keeganmjgreen/rc_car/docs/index.md

# RC Car Mark II

## Power Electronics Design — Custom Unidirectional [Motor Driver](https://en.wikipedia.org/wiki/Motor_controller)

[~~Motor Soft Starter~~](https://en.wikipedia.org/wiki/Motor_soft_starter)

**NPN [bipolar junction transistor (BJT)](https://en.wikipedia.org/wiki/Bipolar_junction_transistor) — [common-emitter](https://en.wikipedia.org/wiki/Common_emitter) ~~amplifier~~ *switching device*:**

$ \displaystyle \begin{aligned} \left. \begin{aligned} & \begin{aligned} \begin{aligned} \textsf{saturation} \\ \textsf{region of} \\ \textsf{operation} \end{aligned} \quad & \implies \quad \left\{ \quad \begin{aligned} & \begin{aligned} \bullet \quad v_C < v_B & \implies \boxed{v_{CE} = V_{CC} - i_C R_C} < v_{BE} \\ & \implies i_C > \left( V_{CC} - v_{BE} \right) / R_E \end{aligned} \\\\ & \bullet \quad \beta_{\, \textsf{forced}} < \beta \ \textsf{(current gain)} \\\\ & \bullet \quad i_B = \frac{i_C}{\beta_{\, \textsf{forced}}} \end{aligned} \quad \right\} \\\\ & \implies \quad i_B > \frac{\left( V_{CC} - v_{BE} \right) / R_C}{\beta} \end{aligned} \\\\ & \boxed{v_{BE} = V_{BB} - i_B R_B} \implies i_B = \left( V_{BB} - v_{BE} \right) / R_B \end{aligned} \quad \right\} \quad & \implies \quad \beta \, \cdot \frac{V_{BB} - v_{BE}}{R_B} > \frac{V_{CC}  - v_{BE}}{R_C} \\ & \implies \quad R_B < R_C \cdot \beta \, \cdot \frac{V_{BB} - v_{BE}}{ V_{CC}  - v_{BE}} \\\\ & \implies \quad R_B < R_{a} \cdot \beta \, \cdot \frac{V_{BB} - V_{\, \mathrm{D}, \, \textsf{on}}}{ V_{CC} - V_{\, \mathrm{D}, \, \textsf{on}}} \end{aligned} $

$ \displaystyle R_B \lessapprox 1 \ \Omega \, \cdot 100 \, \cdot \frac{5.0 \ \mathrm{V} - 0.7 \ \mathrm{V}}{7.4 \ \mathrm{V} - 0.7 \ \mathrm{V}} \approx 64.2 \ \Omega \implies R_B = 50 \ \Omega = ( 100 \ \Omega \parallel 100 \ \Omega ) \ \textsf{on-hand} $

$ \displaystyle i_B \approx \frac{5.0 \ \mathrm{V} - 0.7 \ \mathrm{V}}{50 \ \Omega} = 86 \ \mathrm{mA} \gg 40 \ \mathrm{mA} \ \textsf{max per I/O Pin(s?)} \quad \textsf{(!)} $

------

Figure 1a: Modified from [1]. $ \qquad $ Figure 1b: Modified from [1].

Figure 1: Modified from [1].

------

$ \implies $ **[Darlington pair](https://en.wikipedia.org/wiki/Darlington_transistor):** input transistor ($ \mathrm{Q}_I $), output transistor(s?)(TBD) ($ \mathrm{Q}_O $)  …

$ \displaystyle R_B \lessapprox 1 \ \Omega \, \cdot \left( 100 \right) \left( 100 + 1 \right) \cdot \frac{5.0 \ \mathrm{V} - 2 \cdot 0.7 \ \mathrm{V}}{7.4 \ \mathrm{V} - 2 \cdot 0.7 \ \mathrm{V}} \ \textsf{(?)} = 6060 \ \Omega \implies R_B = \boxed{5500 \ \Omega = \textsf{four on-hand} \ 22 \mathrm{k} \textsf{'s in parallel}} $

$ \displaystyle i_B \approx \frac{5.0 \ \mathrm{V} - 2 \cdot 0.7 \ \mathrm{V}}{5500 \ \Omega} \approx \boxed{0.7 \ \mathrm{mA} \ll 40 \ \mathrm{mA} \ \textsf{max per I/O Pin(s?)}} $

$ v_a \, \left( \, = v_{a, \, \textsf{max}} \right) = V_{CC} - v_{CE, \, \textsf{sat}} \approx 7.4 \ \mathrm{V} - \left( 0.2 \ \mathrm{V} + 0.7 \ \mathrm{V} \right) = \boxed{\textsf{only} \ 6.5 \ \mathrm{V} \left( < 7.4 \ \mathrm{V} \right) \ \textsf{across armature}} $

$ \displaystyle i_a \! \left( t = 0 \right) = \frac{v_a}{R_a} = \frac{6.5 \ \mathrm{V}}{1 \ \Omega} = \boxed{6.5 \ \mathrm{A} \ \textsf{starting current draw}} \quad \textsf{(!)} $

$ \displaystyle \beta_{\, \textsf{forced}} = \frac{i_C}{i_B} = \frac{6.5 \ \mathrm{A}}{0.7... \ \mathrm{mA}} \approx \boxed{9.930.6 \ \mathrm{A} / \mathrm{mA}} $

$ \displaystyle \implies n_{\mathrm{Q}_O \! \textsf{'s}} = \frac{i_C}{i_{C, \, \textsf{max}}} = \frac{6.5 \ \mathrm{A}}{0.6 \ \mathrm{A}} \approx 10.8 \implies \boxed{12 \ \textsf{in parallel} \ \mathrm{Q}_O \! \textsf{'s}} = \underbrace{4 \ \textsf{tie points} \times 3 \ \textsf{five-tie point terminals}}_{\textsf{proto-board}} $

- **Which kind of switching device?**

  Medium-power NPN [bipolar junction transistor (BJT)](https://en.wikipedia.org/wiki/Bipolar_junction_transistor)’s on-hand.

  `PN2222A-D32`

- **Which circuit topology/configuration?**

  Overall: [common-emitter](https://en.wikipedia.org/wiki/Common_emitter) ~~amplifier~~ *switching device*.

  [Darlington pair](https://en.wikipedia.org/wiki/Darlington_transistor).

- **Which transistors? How many? How many stages? Which ‘region’ of operation?**

  Stage 1: 600-mA [or less] NPN’s (×1) in saturation. Alternative: motor driver board.
  Stage 2: 600-mA NPN’s (×12) pushing saturation.

- **What current-limiting resistance? Which resistors? How many?**

  $ R_B \lessapprox 6060 \ \Omega \, \longrightarrow 5500 \ \Omega = \textsf{four on-hand} \ 22 \mathrm{k} \textsf{'s in parallel} $.

**Failure analysis:**

- Factor 1: One-at-a-time activation and subsequent burnout of all stage 2 BJTs.

- Factor 2: Nonzero load (non-frictional) torque (‘freewheeling’).

  $ \displaystyle \textsf{starting inrush current} \begin{aligned}[t] & \longrightarrow \textsf{motor starts} \\ & \longrightarrow \textsf{gears backlash against nonzero torque} \\ & \longrightarrow \textsf{motor slows down} \\ & \longrightarrow \textsf{sustained inrush current} \\ & \longrightarrow \textsf{BJTs burn out} \\ & \longrightarrow \textsf{current stops} \\ & \longrightarrow \textsf{motor stops}  \end{aligned} $

Me:

> This is the scene from The Martian that the failure mode of my RC car's parallel and redundant transistors reminded me of:
>
> > Though [space probe] Iris was held in place by five large bolts, the force was directed entirely to a single one. The bolt was designed to withstand immense forces; if necessary to carry the entire weight of the payload. But it was not designed to sustain a sudden impact from a loose three-hundred-kilogram mass.
> >
> > The bolt sheared. The burden was then shifted to the remaining four bolts. The forceful impact having passed, their work was considerably easier than that of their fallen comrade.
> >
> > Had the pad crew been given time to do normal inspections, they would have noticed the minor defect in one of the bolts. A defect that slightly weakened it, though it would not cause failure on a normal mission. Still, they would have swapped it out with a perfect replacement.
> >
> > The off-center load presented unequal force to the four remaining bolts, the defective one bearing the brunt of it. Soon, it failed as well. From there, the other three failed in rapid succession.
>
> But: Even a slight pretest defect in one of the bolts? Unequal force on the four remaining bolts, when each was designed to carry the entire payload? …

My project member:

> … I like the flow of the description of the failure its very in the realm of engineering. It evokes the chaos that these sorts of failures produce, in like you said a chain reaction, like the frozen o-ring in the Challenger launch failure. Though technical in language, it describes the mechanisms in which any mechanical or conceptual system can fail like a car crash in slow motion or your life crumbling around you. Like who thought that was a good idea to have so much hinge on small aspects? What engineer thought up the FoS, what technician thought that looked fine, everyone has lives to get back to and other things to think about. Maybe sometimes you should sweat the small details before you have to find out about a larger system at work
>
> I like to think of your motor drive as the little engine that could. Keep stacking the redundancy, until it looks like a GPU power phase, that baby’s got a honking motor and she’s gotta RIDE

$ \displaystyle R_B < R_{\, \textsf{coil}} \cdot \beta \, \cdot \frac{V_{BB} - V_{\, \mathrm{D}, \, \textsf{on}}}{ V_{CC} - V_{\, \mathrm{D}, \, \textsf{on}}} = 225 \ \Omega \cdot 100 \cdot \frac{5.0 \ \mathrm{V} - 0.7 \ \mathrm{V}}{7.4 \ \mathrm{V} - 0.7 \ \mathrm{V}} \approx 14.4 \ \mathrm{k} \Omega \implies R_B = \boxed{\, ? \,} $

$ \displaystyle i_B \approx \frac{5.0 \ \mathrm{V} - 0.7 \ \mathrm{V}}{?} \approx \; ?? \ll 40 \ \mathrm{mA} \ \textsf{max per I/O Pin(s?)} $

$ v_{\, \textsf{coil}} \, \left( \, = v_{\, \textsf{coil}, \, \textsf{max}} \right) = V_{CC} - v_{CE, \, \textsf{sat}} \approx 7.4 \ \mathrm{V} - 0.7 \ \mathrm{V} = \boxed{\textsf{only} \ 6.7 \ \mathrm{V} \left( < 7.4 \ \mathrm{V} \right) \ \textsf{across relay coil}} $

$ \displaystyle i_a \! \left( t = 0 \right) = v_a / R_a = \boxed{7.4 \ \mathrm{V}} \; / \left( 1 \ \Omega \right) = \boxed{7.4 \ \mathrm{A} \ \textsf{starting current draw}} \quad \textsf{(!)} $

## [Powertrain](https://en.wikipedia.org/wiki/Powertrain) Design

**[Brushed DC electric motor](https://en.wikipedia.org/wiki/Brushed_DC_electric_motor):**

- Model airplane propeller drive.

- No datasheet or specifications within reach.

  ```
  51287V2
  610223-1(B)
  ```

### [Drivetrain](https://en.wikipedia.org/wiki/Drivetrain) Design

$ \displaystyle R = \frac{\mathrm{rpm}_A}{\mathrm{rpm}_B} \, \left( = \frac{\omega_A}{\omega_B} = \frac{r_A}{r_B} \right) = \frac{N_A}{N_B} = \frac{24 \ \textsf{teeth}}{\phantom{0}8 \ \textsf{teeth}} = \boxed{\, 3 : 1 \,} \implies R_\textsf{tot.} = \prod_{i=1}^{n} R_i = \left( R \right) ^ n = \left( 3 \right) ^ 4 = \boxed{\, 81 : 1 \,} $

**Alternatives:**

- +1 three-to-one’s $ \implies $ too slow
- −1 three-to-one’s $ \implies $ too fast
- +1 two-to-one’s $ \implies $ not enough chassis space
- −1 three-to-one’s + 1 two-to-one $ \implies $ not enough chassis space — ?
- −2 three-to-one’s + 1 two-to-one $ \implies $ too fast

## [Chassis](https://en.wikipedia.org/wiki/Chassis) Design

LEGO Technic

| Components | Dimensions (Approx.) |
| --- | --- |
| [Frame](https://en.wikipedia.org/wiki/Vehicle_frame) | 12 cm × 12 cm |
| [Axle Track](https://en.wikipedia.org/wiki/Axle_track) | 20 cm |
| [Wheelbase](https://en.wikipedia.org/wiki/Wheelbase) | |
| Length | 17 cm |
