keeganmjgreen/rc_car/docs/img/20210618_133451.jpg

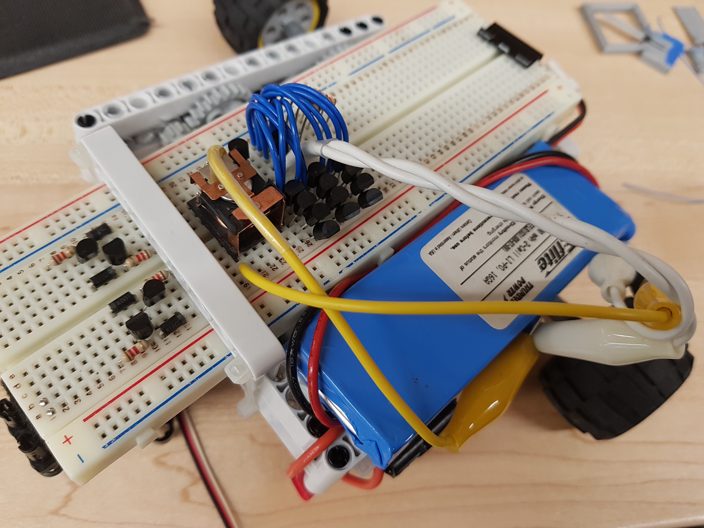
docs/img/20210618_133451.jpg
