keeganmjgreen/rc_car/docs/img/20210618_133456.jpg

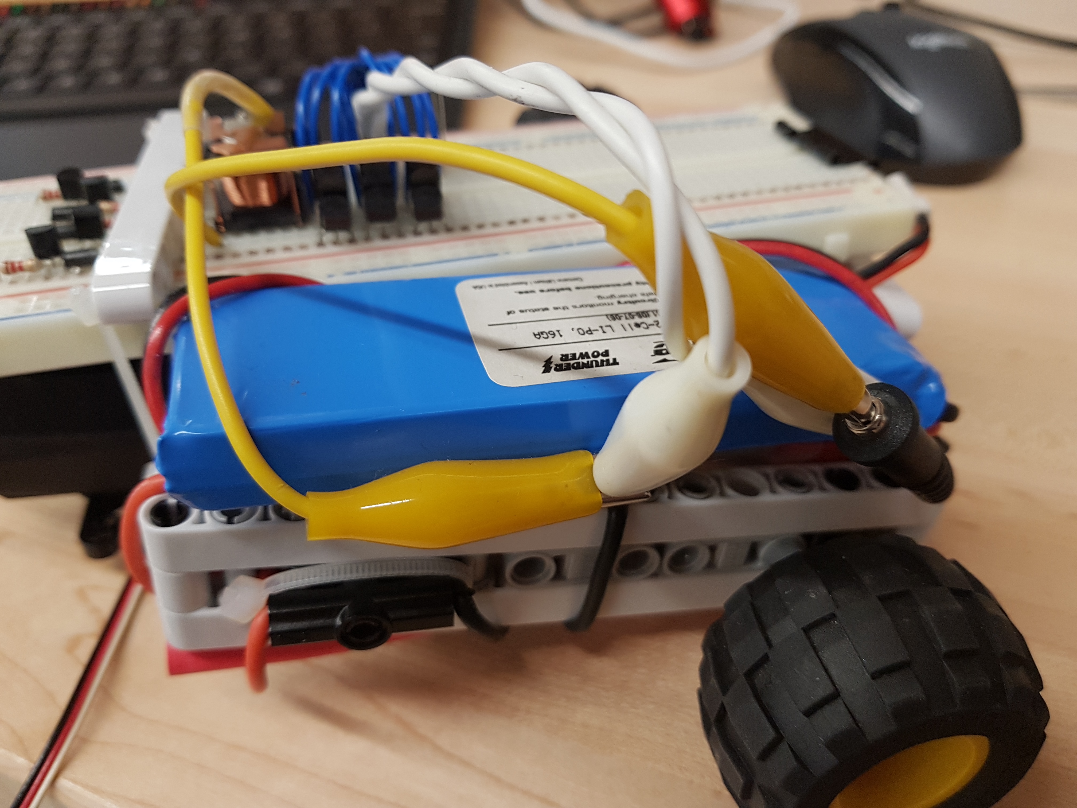
docs/img/20210618_133456.jpg
