keeganmjgreen/rc_car/docs/img/20210618_133459.jpg

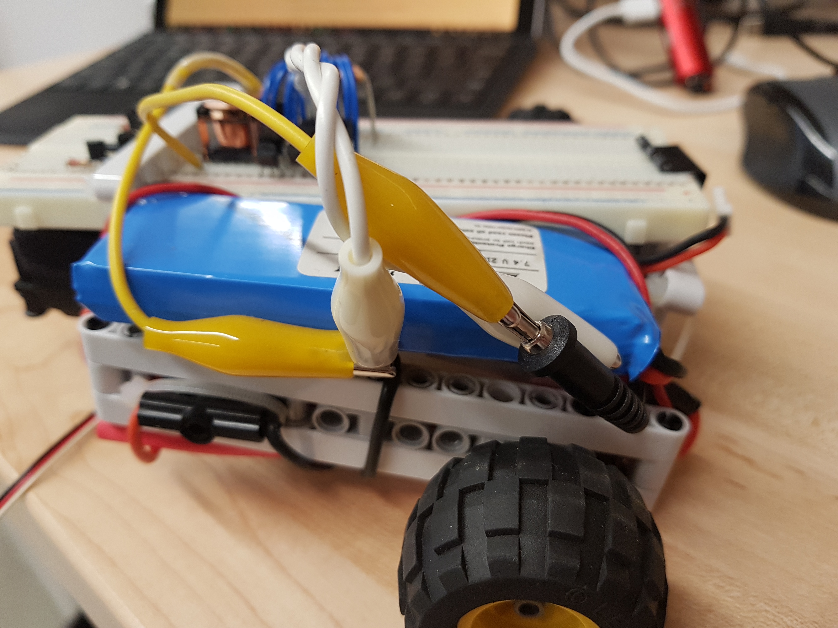
docs/img/20210618_133459.jpg
