keeganmjgreen/rc_car/docs/img/20210618_133501.jpg

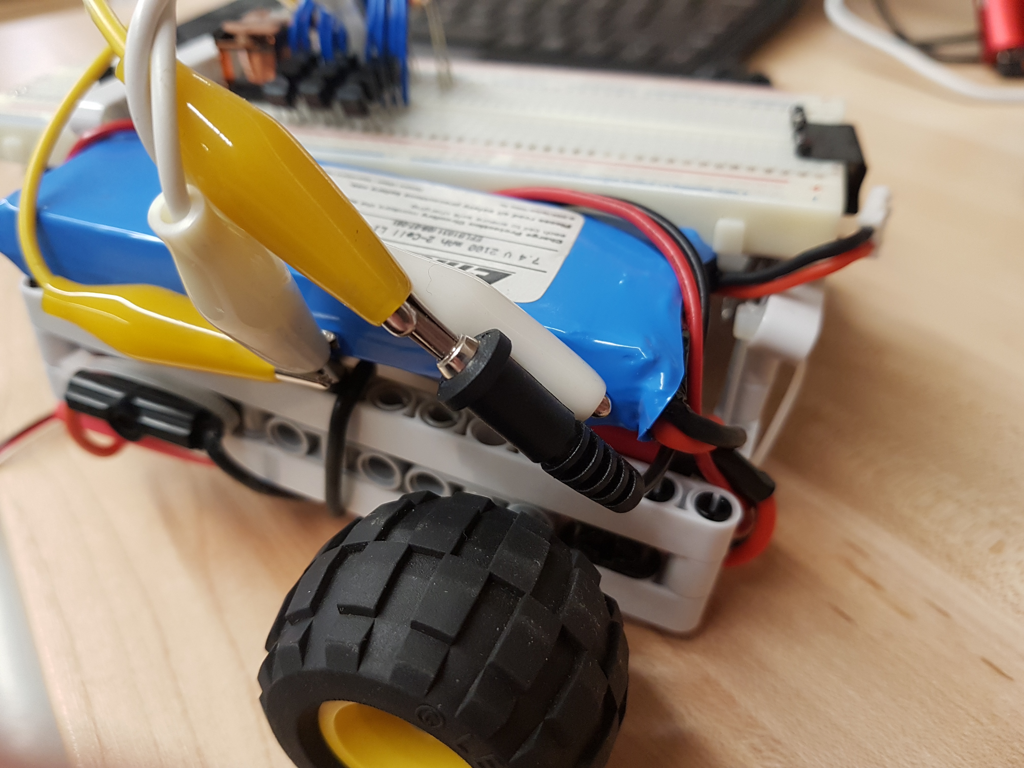
docs/img/20210618_133501.jpg
