keeganmjgreen/rc_car/docs/img/Darlington_pair_diagram.svg.png

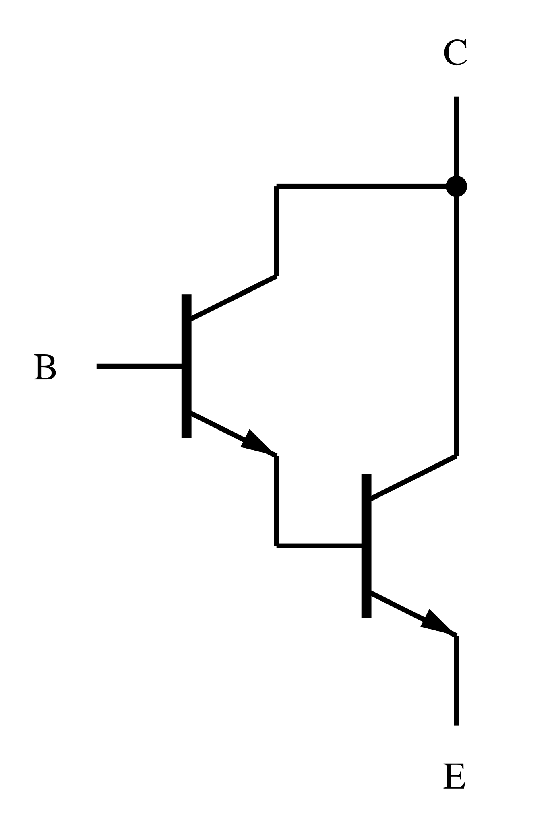
docs/img/Darlington_pair_diagram.svg.png
