keeganmjgreen/rc_car/rc_car_mark_i_interface/window_bg.png

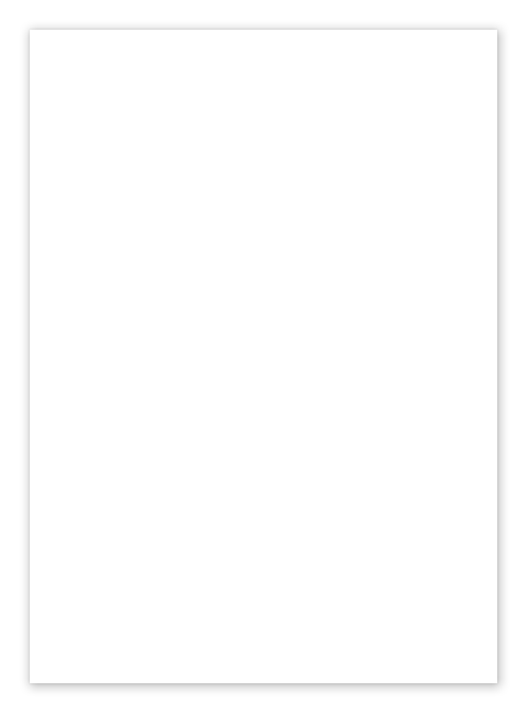
rc_car_mark_i_interface/window_bg.png
